ibll/NixieGlucoseDisplay/(commit log)

2025-08-26 Switched to ArduinoHTTPClient
2025-09-01 swapped file name, other stuff idk
    [Omnixie_NTDB.h, icons.h]
2025-09-11 made slot machine happen on transition
2025-09-26 Add secrets template, rename for arduino ide
2025-10-06 Change arduino image
2026-05-16 Swap to standard http libraries
    [arduino-glucose.ino]
2026-05-16 Replace strings with char arrays
    Temp
    [arduino-glucose.ino]
2026-05-16 Fix incorrect comparison, add comments
    [arduino-glucose.ino]
2026-05-16 Fix potential mishandling of \r\n line endings
    [arduino-glucose.ino]
2026-07-10 Increase slot machine time to prevent cathode poisoning
    [arduino-glucose.ino]
